feverittm/SuperTester/README.md

# SuperTester
First Robotics Electrical Tester
Unified Tester for most electronic controls on a FIRST Robotics robot.
Includes conntections for PWM, Spike, Analog, Digital (including encoder), and I2C (specific code for Accelerometer)
Needs to have CAN added.
