feverittm/SuperTester/SuperTester-v08.TXT

%
M48
M72
T01C0.0200
T02C0.0236
T03C0.0240
T04C0.0315
T05C0.0320
T06C0.0394
T07C0.0400
T08C0.0433
T09C0.0440
T10C0.0790
T11C0.0800
T12C0.0866
T13C0.1102
T14C0.1770
%
T01
X14760Y18393
X13260Y18893
X15260Y22893
X19760Y23393
X19760Y21893
X25760Y17393
X26760Y19393
X29760Y16393
X33260Y16393
X33760Y17393
X35760Y14893
X35260Y13393
X36760Y19393
X38760Y23393
X29760Y23393
X23760Y28393
X15260Y29893
T02
X10760Y26893
X10760Y24893
X16760Y22893
X20760Y19893
X19760Y18393
X30260Y26393
X33260Y26393
X33760Y27393
X37260Y28393
X31260Y20893
X32760Y18393
X39260Y16393
X41760Y9393
T03
X30260Y18893
T04
X28760Y26893
X27760Y26893
X26760Y26893
T05
X26760Y24893
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
