feverittm/SuperTester/Ver 7/SuperTester-v07.TXT

%
M48
M72
T01C0.0200
T02C0.0240
T03C0.0315
T04C0.0320
T05C0.0394
T06C0.0400
T07C0.0433
T08C0.0440
T09C0.0630
T10C0.1102
T11C0.1770
%
T01
X11260Y14393
X13260Y18393
X15760Y19393
X15260Y22393
X11260Y24393
X15260Y29393
X19760Y22893
X19760Y21393
X19760Y17893
X25760Y16893
X26760Y18893
X29760Y15893
X32760Y17893
X33760Y16893
X33260Y15893
X35760Y14393
X35260Y12893
X39760Y17893
X36760Y18893
X32260Y20393
X29760Y22893
X33260Y26393
X38760Y22893
X23760Y27893
T02
X30260Y18393
X30760Y17393
T03
X28760Y26393
X27760Y26393
X26760Y26393
T04
X26760Y24393
X27760Y24393
X28760Y24393
X29760Y24393
X30760Y24393
X31760Y24393
X32760Y24393
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
