feverittm/SuperTester/SuperTester-v08-sch.pdf

A

A

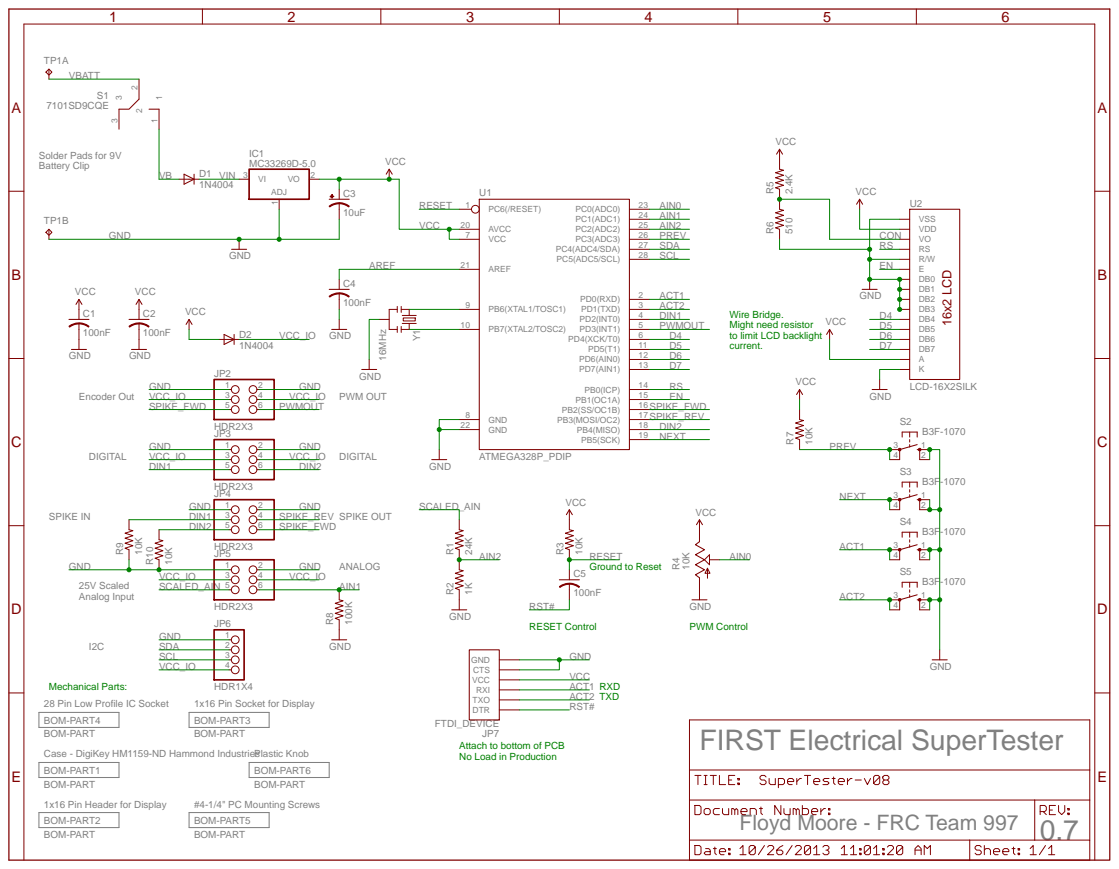
[picture p1: page 1]

Wire Bridge.
Might need resistor
to limit LCD backlight
current.

Mechanical Parts:
28 Pin Low Profile IC Socket
BOM-PART4
BOM-PART
Case - DigiKey HM1159-ND Hammond Industries
BOM-PART1
1x16 Pin Header for Display
BOM-PART2

Attach to bottom of PCB
No Load in Production

Floyd Moore - FRC Team 997
