feverittm/SuperTester/Ver 7/SuperTester-v07-sch.pdf

A

A

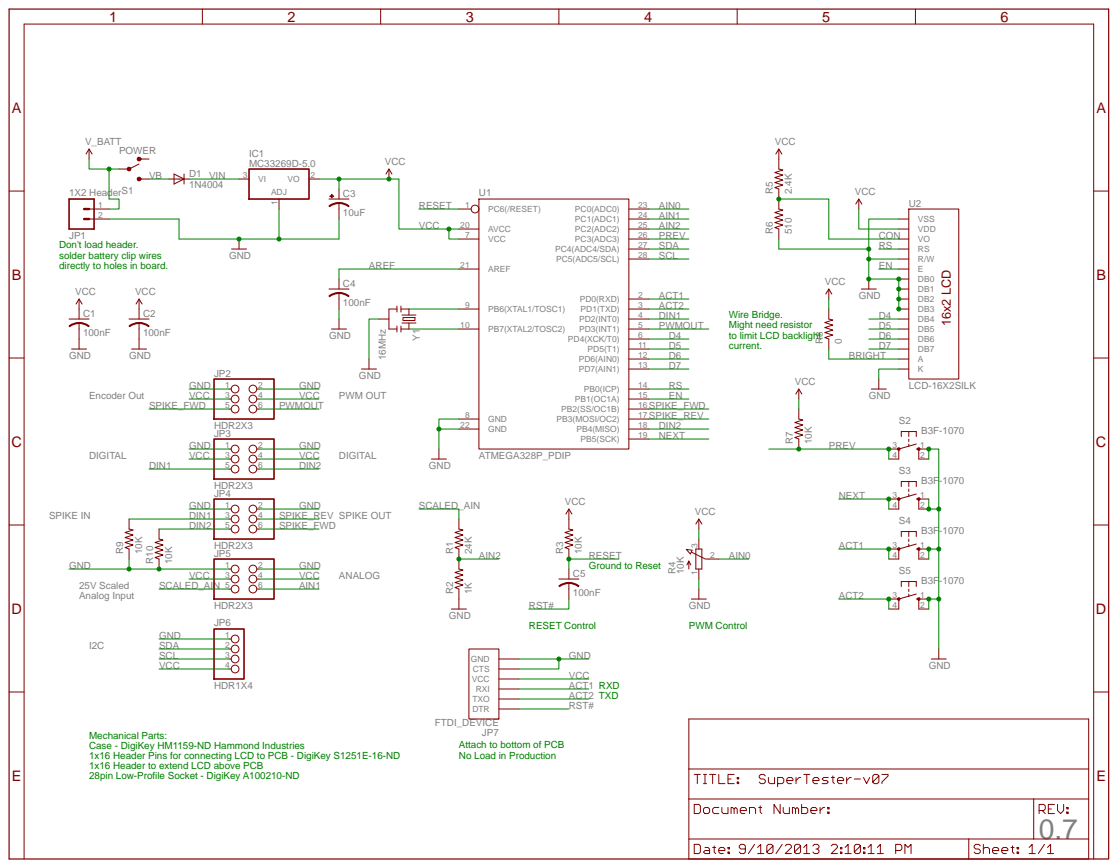
[picture p2: page 1]

Wire Bridge.
Might need resistor
to limit LCD backlight
current.

Mechanical Parts:
Case - DigiKey HM1159-ND Hammond Industries
1x16 Header Pins for connecting LCD to PCB - DigiKey S1251E-16-ND
1x16 Header to extend LCD above PCB
28pin Low-Profile Socket - DigiKey A100210-ND

Attach to bottom of PCB
No Load in Production
