feverittm/SuperTester/SuperTester-v08-parts_dwg.pdf

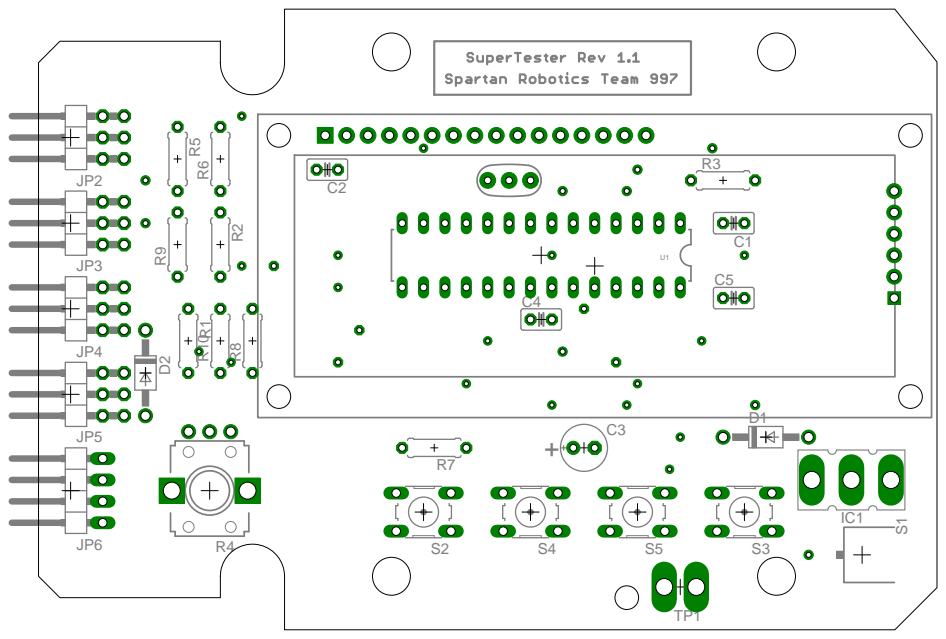
[picture p3: page 1]
