feverittm/SuperTester/SuperTester-v08-pcb.pdf

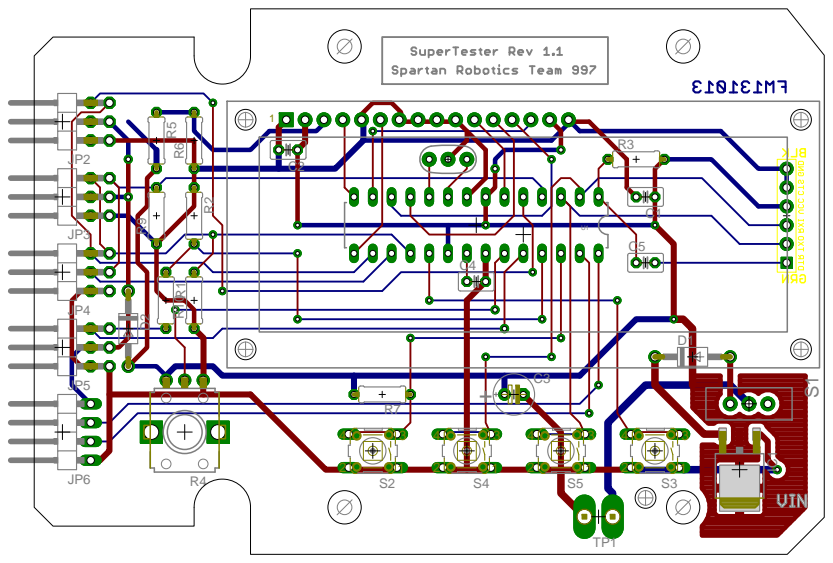
[picture p4: page 1]
