feverittm/SuperTester/Ver 7/SuperTester-v07-parts_dwg-A.pdf

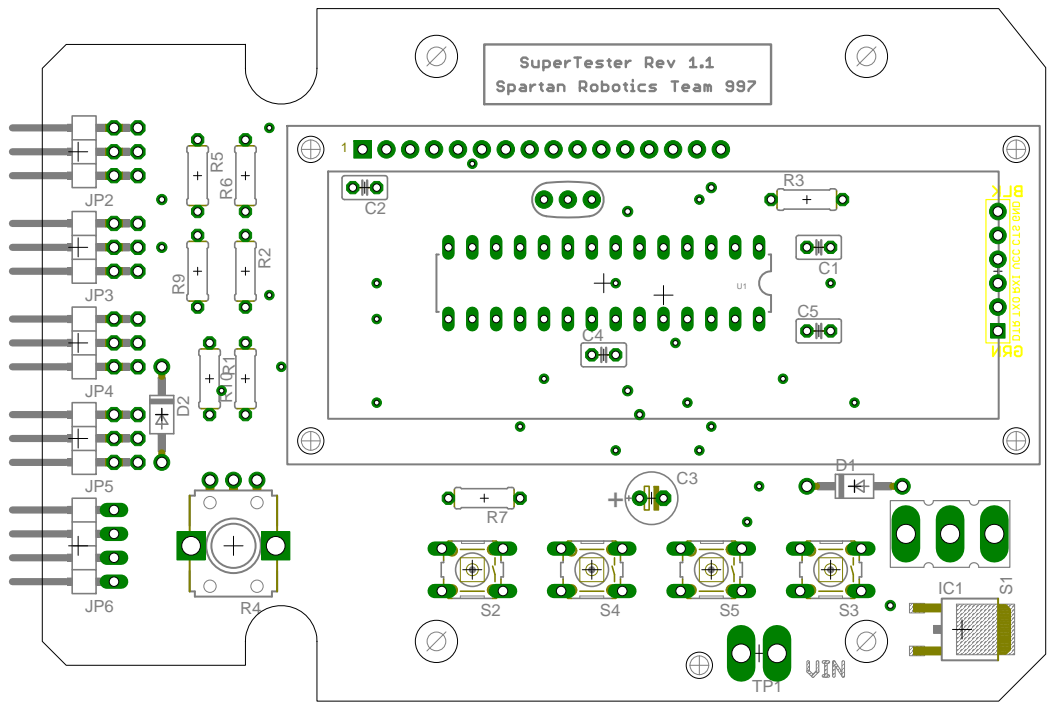
[picture p5: page 1]
