feverittm/SuperTester/Ver 7/SuperTester-v07-parts_dwg.pdf

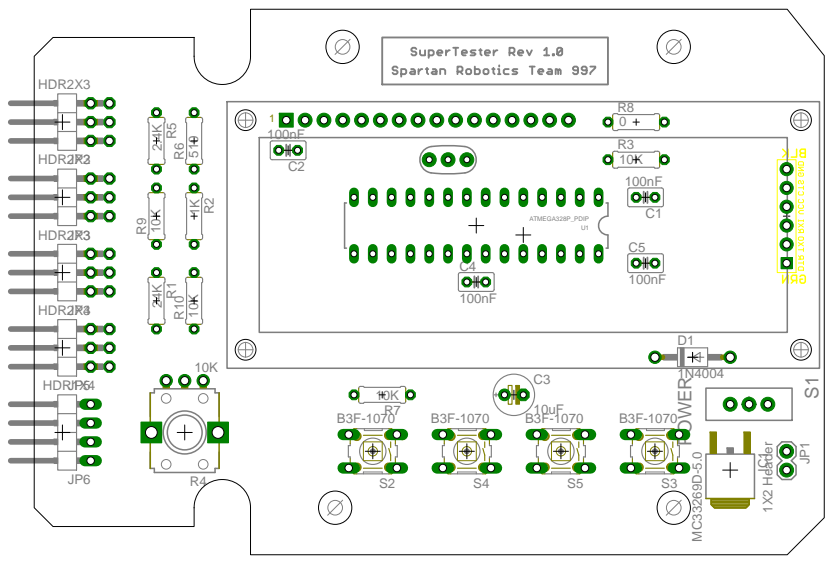
[picture p6: page 1]
