feverittm/SuperTester/Ver 7/SuperTester-v07-pcb.pdf

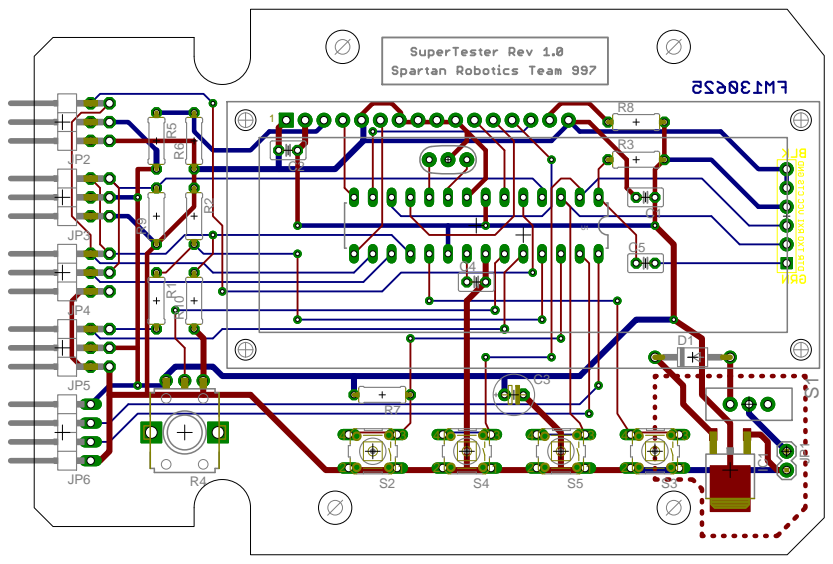
[picture p7: page 1]
