feverittm/SuperTester/Ver 7/SuperTester-v07.brd

## EAGLE design Ver 7/SuperTester-v07.brd (2015-01-16)

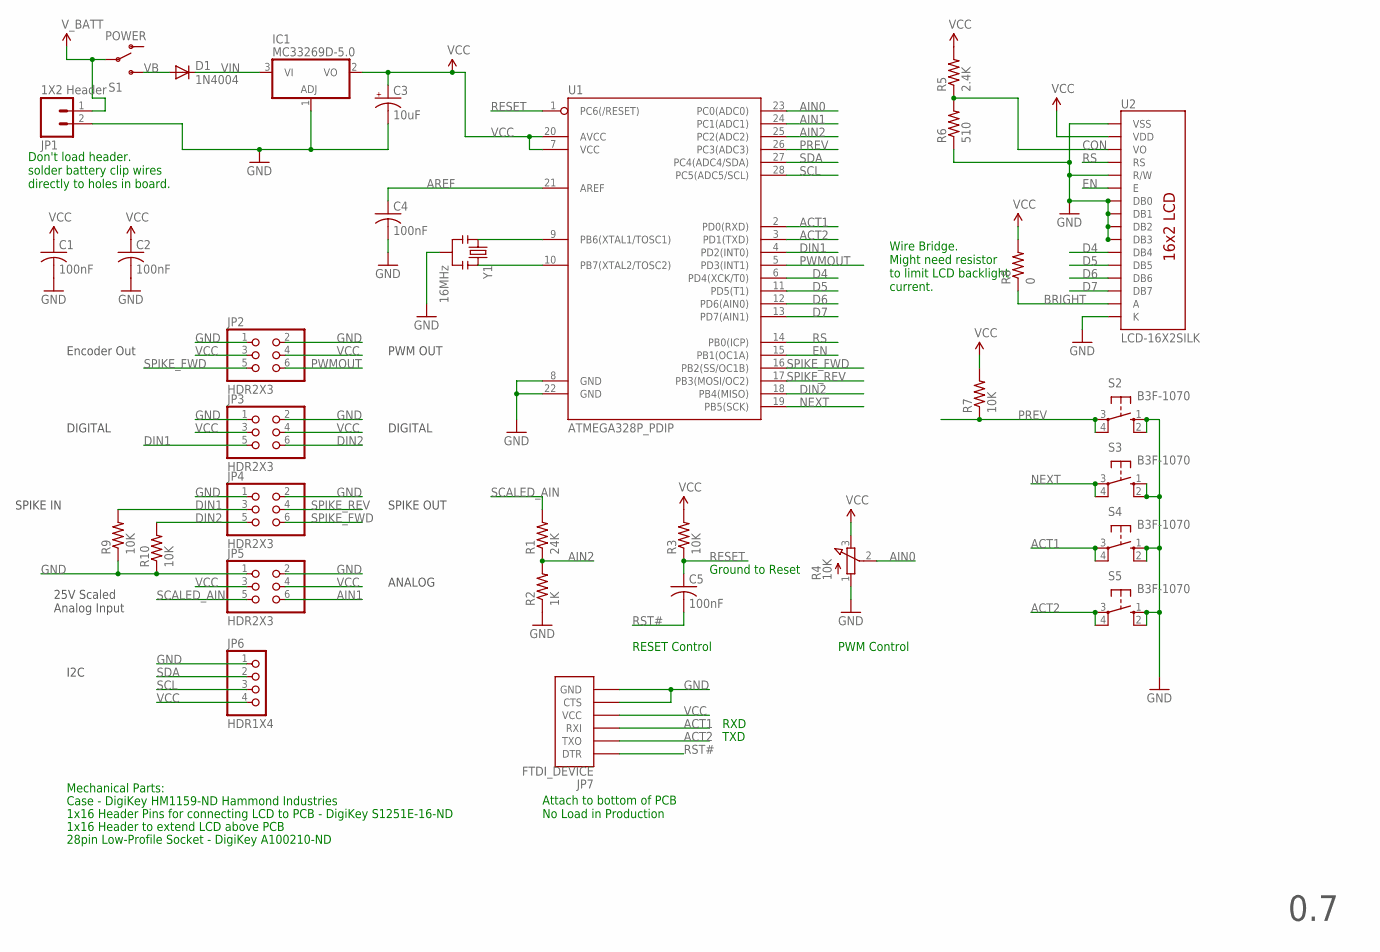
[picture p8: schematic SuperTester-v07.sch]

Parts:
C1, C2, C4, C5: 100nF; C025-025X050; PARTNO SR295E104MAR
C3: 10uF; E2,5-6E; PARTNO TAP106M025SCS
D1: 1N4004; DO41-10; PARTNO 1N4004GP-E3/54
IC1: MC33269D-5.0; DPACK; PARTNO MC33269DTRK-5.0G
JP1: 1X2 Header; 1X02; PARTNO 640456-2
JP2, JP3, JP4, JP5: HDR2X3; 2X03/90; PARTNO 68021-206HLF
JP6: HDR1X4; 1X04/90; PARTNO 68016-204HLF
JP7: FTDI_DEVICE; FTDI_DEVICE_SIDE; PARTNO 826926-6
R1: 24K; 0207/7; PARTNO CFR-12JB-52-24K
R2: 1K; 0207/7; PARTNO CFR-12JB-52-1K
R3, R7, R9, R10: 10K; 0207/7; PARTNO CFR-12JB-52-10K
R4: 10K; EVUF; PARTNO EVU-F3AF30B14
R5: 2.4K; 0207/7; PARTNO CFR-12JB-52-2K4
R6: 510; 0207/7; PARTNO CFR-12JB-52-510R
R8: 0; 0207/7; PARTNO ZOR-12-B-52-0R
S1: POWER; SWITCH-SPDT; PARTNO EG1218
S2, S3, S4, S5: B3F-1070; B3F-10XX; PARTNO B3F-1070
U1: ATMEGA328P_PDIP; DIL28-3; PARTNO ATMEGA328P-PU
U2: LCD-16X2SILK; LCD-16X2; PARTNO LCM-S01602DSF/A
Y1: 16MHz; RESONATOR-PTH; PARTNO CSTLS16M0X53-B0

Connections:
ACT1: JP7.P$3 (RXI), S4.3, S4.4 (P1), U1.2 (PD0(RXD))
ACT2: JP7.P$2 (TXO), S5.3, S5.4 (P1), U1.3 (PD1(TXD))
AIN0: R4.2 (S), U1.23 (PC0(ADC0))
AIN1: JP5.6, U1.24 (PC1(ADC1))
AIN2: R1.1, R2.2, U1.25 (PC2(ADC2))
AREF: C4.1, U1.21 (AREF)
BRIGHT: R8.1, U2.15 (A)
CON: R5.1, R6.2, U2.3 (VO)
D4: U1.6 (PD4(XCK/T0)), U2.11 (DB4)
D5: U1.11 (PD5(T1)), U2.12 (DB5)
D6: U1.12 (PD6(AIN0)), U2.13 (DB6)
D7: U1.13 (PD7(AIN1)), U2.14 (DB7)
DIN1: JP3.5, JP4.3, R9.2, U1.4 (PD2(INT0))
DIN2: JP3.6, JP4.5, R10.2, U1.18 (PB4(MISO))
EN: U1.15 (PB1(OC1A)), U2.6 (E)
GND: C1.2, C2.2, C3.-, C4.2, IC1.1 (ADJ), JP1.2, JP2.1, JP2.2, JP3.1, JP3.2, JP4.1, JP4.2, JP5.1, JP5.2, JP6.1, JP7.P$5 (CTS), JP7.P$6 (GND), R2.1, R4.1 (A), R6.1, R9.1, R10.1, S2.1 (S), S2.2 (S1), S3.1 (S), S3.2 (S1), S4.1 (S), S4.2 (S1), S5.1 (S), S5.2 (S1), U1.8 (GND), U1.22 (GND), U2.1 (VSS), U2.5 (R/W), U2.7 (DB0), U2.8 (DB1), U2.9 (DB2), U2.10 (DB3), U2.16 (K), Y1.2
NEXT: S3.3, S3.4 (P1), U1.19 (PB5(SCK))
PREV: R7.1, S2.3, S2.4 (P1), U1.26 (PC3(ADC3))
PWMOUT: JP2.6, U1.5 (PD3(INT1))
RESET: C5.1, R3.1, U1.1 (PC6(/RESET))
RS: U1.14 (PB0(ICP)), U2.4 (RS)
RST#: C5.2, JP7.P$1 (DTR)
SCALED_AIN: JP5.5, R1.2
SCL: JP6.3, U1.28 (PC5(ADC5/SCL))
SDA: JP6.2, U1.27 (PC4(ADC4/SDA))
SPIKE_FWD: JP2.5, JP4.6, U1.16 (PB2(SS/OC1B))
SPIKE_REV: JP4.4, U1.17 (PB3(MOSI/OC2))
VB: D1.A, S1.3 (S)
VCC: C1.1, C2.1, C3.+, IC1.2 (VO), JP2.3, JP2.4, JP3.3, JP3.4, JP5.3, JP5.4, JP6.4, JP7.P$4 (VCC), R3.2, R4.3 (E), R5.2, R7.2, R8.2, U1.7 (VCC), U1.20 (AVCC), U2.2 (VDD)
VIN: D1.C, IC1.3 (VI)
V_BATT: JP1.1, S1.2
XTAL1: U1.9 (PB6(XTAL1/TOSC1)), Y1.1
XTAL2: U1.10 (PB7(XTAL2/TOSC2)), Y1.3

Notes on the sheet:
PWM Control
Encoder Out
DIGITAL
ANALOG
PWM OUT
SPIKE OUT
I2C
25V Scaled Analog Input
RESET Control
Mechanical Parts:
Case - DigiKey HM1159-ND Hammond Industries
1x16 Header Pins for connecting LCD to PCB - DigiKey S1251E-16-ND
Attach to bottom of PCB No Load in Production
Wire Bridge. Might need resistor to limit LCD backlight current.
1x16 Header to extend LCD above PCB
0.7
SPIKE IN
28pin Low-Profile Socket - DigiKey A100210-ND
Don't load header. solder battery clip wires directly to holes in board.
RXD
TXD
Ground to Reset

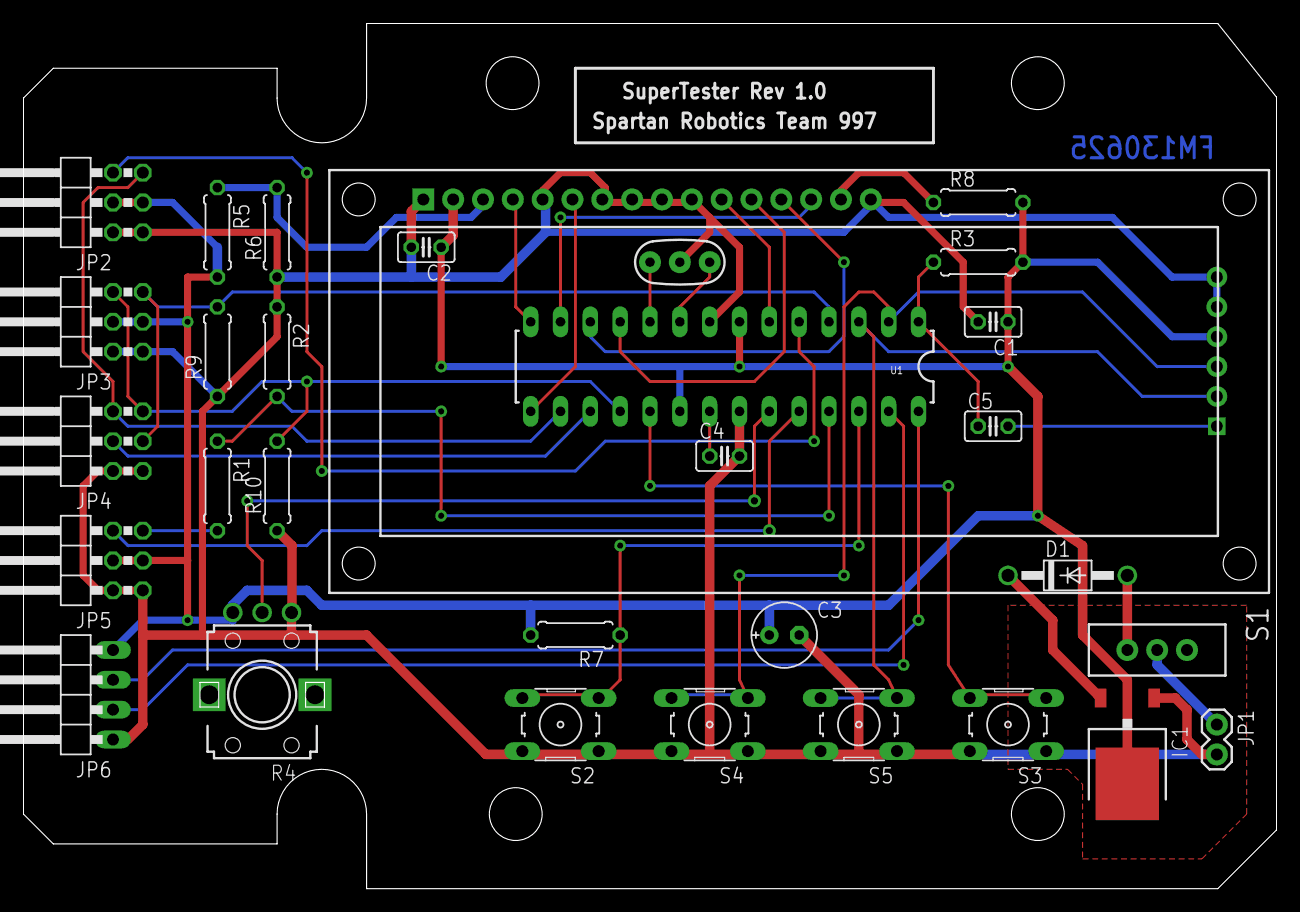
[picture p9: board SuperTester-v07.brd from above]

Board: 2 copper layers, 106.7 x 73.7 mm, 32 parts (1 on the bottom side), 33 nets.
