feverittm/SuperTester/(notices)

Notices in the files:
parts and their libraries:
SparkFun-Displays: Licensing: CC v3.0 Share-Alike You are welcome to use this library for commercial purposes.
bom: Copyright (C) 2010, Bob Starr
